TheoKanning/Dexter/(commit log)

2018-09-25 Add Razor IMU firmware and start serial communication between Arduino boards
2018-09-25 Add ArduinoSerialCommand and parse RPY messages
2018-09-26 Add Controller class
    This class is repsonsible for all PID control logic
2018-09-26 Add Stepper Motor definitions to Arduino file
2018-09-26 Add Arduino controlling logic
2018-09-27 Fix euler angle calculations
    The old calculations changed the roll and pitch axes if the yaw angle changed.
    [Dexter.ino]
2018-10-03 Increase IMU baud rate and attempt to tune
    Steppers are still too slow
    [Dexter.ino]
2018-10-12 Replace MotorShield with A4988
    MotorShield couldn't drive two motors quickly enough, so I replaced it with the A4988 and interrupts on Timer1 and Timer3 of the Teensy.
    [Dexter.ino, Motors.ino]
2018-10-12 Use PID library instead of Controller
2018-10-12 Allow fractional steps per second
    There's no reason why the motors have to take an integer number of steps per second.
2018-10-18 Add microstepping and manually parse serial
    Can't use ArduinoSerialCommand with HardwareSerial.
2018-10-27 Use MPU-9250 for pitch angle
    Calculate angle using a simple complementary filter instead of quaternions. Also added better calibration.
2018-10-27 Remove unused magnetometer and calibration code
2018-10-27 Delete Razor IMU code
    This isn't needed anymore
2018-11-04 Switch to 1/8 microstepping
2018-11-06 Replace MPU-9250 with MPU-6050
    [Dexter.ino, IMU.ino]
2018-11-09 Replace PID library
2018-11-09 Add bluetooth commands and fix calibration
    [Dexter.ino, IMU.ino, Motors.ino, PID.ino]
2018-11-10 Fix bug with angle derivative error
    Error needs to be multiplied by the frequency, not divided
    [Dexter.ino, PID.ino]
2018-11-12 Add separate tuning serial option and 5Hz LPF
2018-11-12 Add pitch smoothing
    Each pitch value is averaged with the previous value for a simple low pass filter
2018-12-05 Add microstepping pin options
    The custom PCB requires the Teensy to control the microstep control pins
2018-12-09 Enforce minimum speed of 1 step per second
    Timer was actually making Dexter move much faster than 1 step per second
2018-12-20 Update default pid constants and speed commands
2019-01-13 Remove speed Kd, add steering, tune
2019-01-15 Adjust steering sensitivity
2019-02-21 Combine scanning into ControlFragment
    Since scanning no longer requires a list of devices, it can be rolled into the ControlFragment
2019-02-24 Simplify BluetoothConnection
    No need to handle incoming messages and track connection state with extra variable
2019-02-24 Close input and output socket streams
    For some reason this is required in order to re-connect without power cycling Dexter
2019-03-03 Fix angular message and add filter to speed commands
    [Dexter.ino]
2019-03-05 Fix speed command math
    [Dexter.ino]
2019-03-16 Add frame .stp and pcb design block links
2019-03-16 Update README formatting
    Put frame and pcb file links on separate lines
